MatteoHMarangoni/bird_detector_esp32/electronics/custom_mic_schematic.png

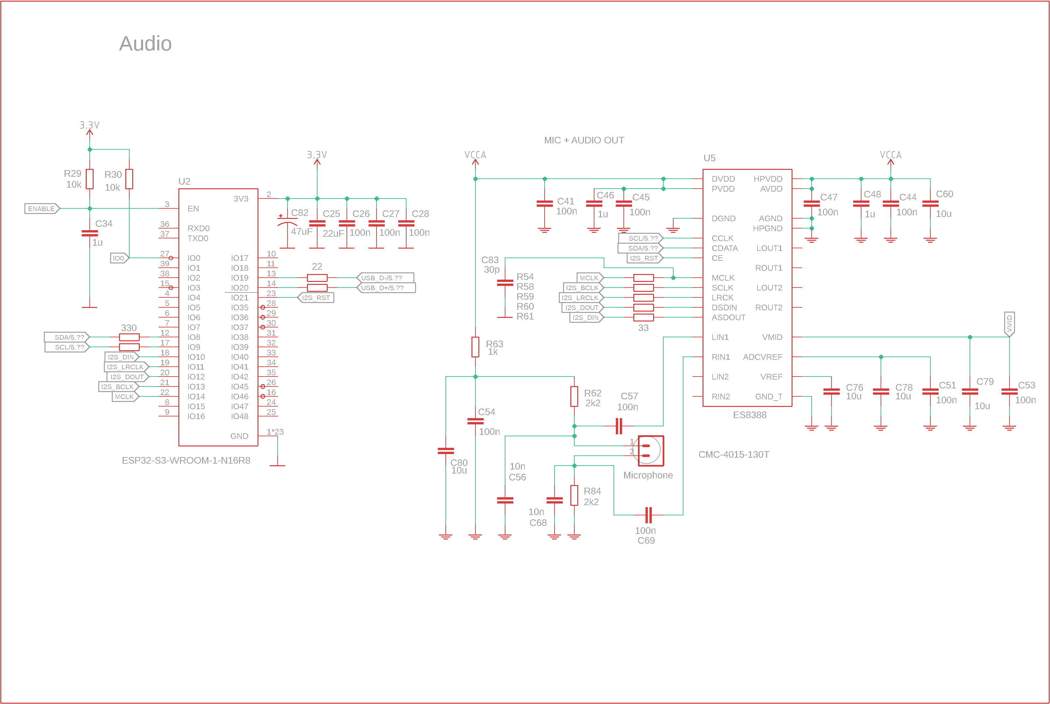
electronics/custom_mic_schematic.png
