MatteoHMarangoni/bird_detector_esp32/(commit log)

2026-02-05 changed model to Zuiderpark, fixed conflict EI, added test dataset
    [main.cpp]
2026-02-15 updated model to published version, added python scripts and schematics
2026-02-17 fixed scripts, added examples raw data for testing scripts
    [main.cpp]
